jonesandjay123/3D-print-layerdock/projects/open-frame/docs/reference/concept-1.jpg

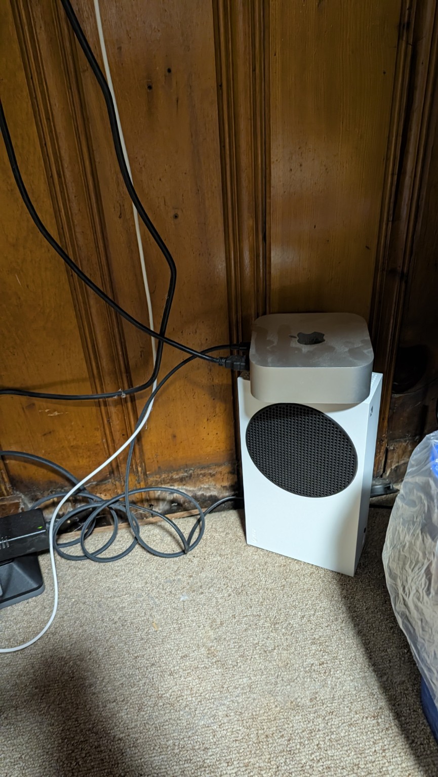
projects/open-frame/docs/reference/concept-1.jpg
