jonesandjay123/3D-print-layerdock/projects/open-frame/docs/reference/concept-4.jpg

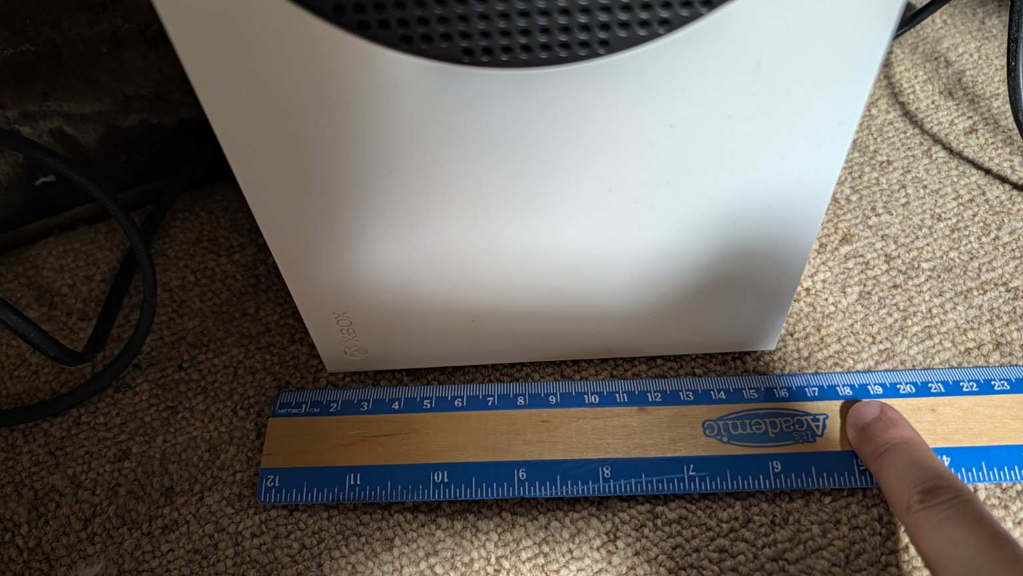
projects/open-frame/docs/reference/concept-4.jpg
