jonesandjay123/3D-print-layerdock/projects/stackable-bins/docs/concepts/concept-A.png

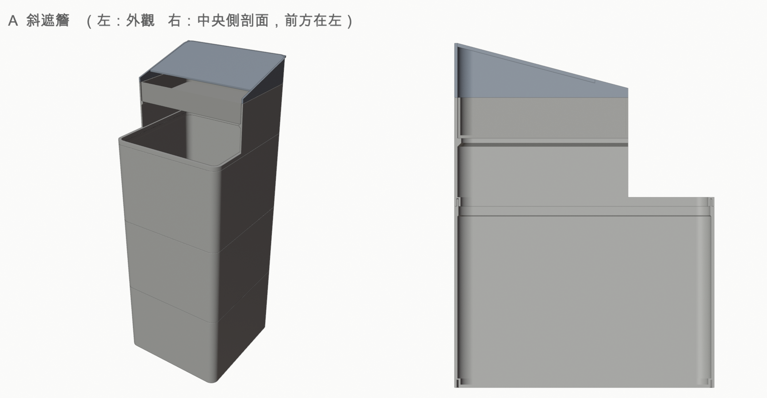
projects/stackable-bins/docs/concepts/concept-A.png
