jonesandjay123/3D-print-layerdock/projects/stackable-bins/docs/concepts/concept-B.png

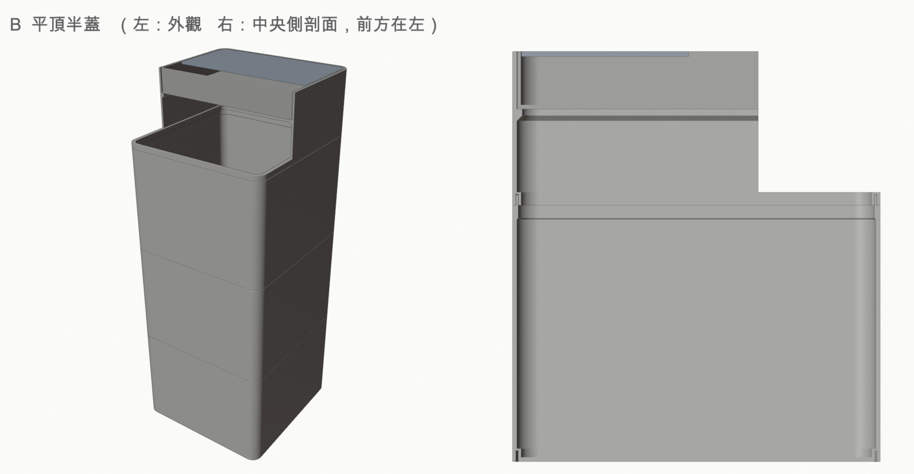
projects/stackable-bins/docs/concepts/concept-B.png
