jonesandjay123/3D-print-layerdock/projects/stackable-bins/docs/concepts/concept-C.png

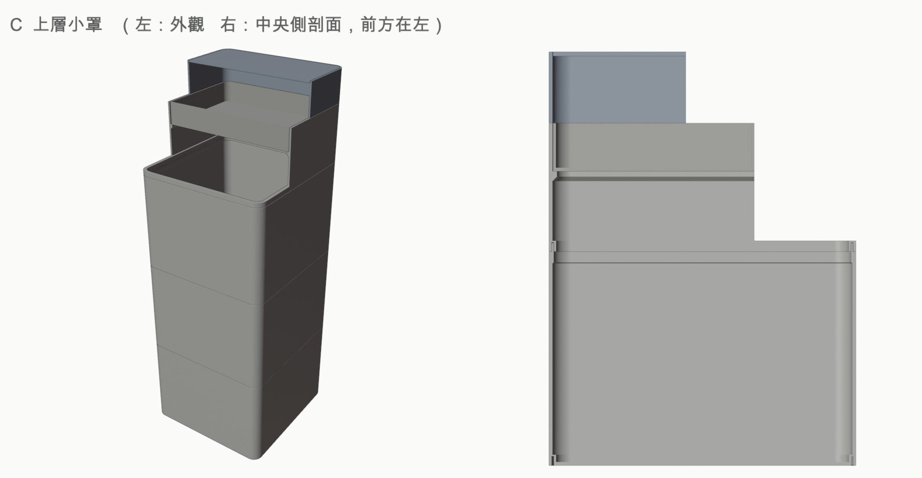
projects/stackable-bins/docs/concepts/concept-C.png
