jonesandjay123/3D-print-layerdock/projects/open-frame/print/top.3mf

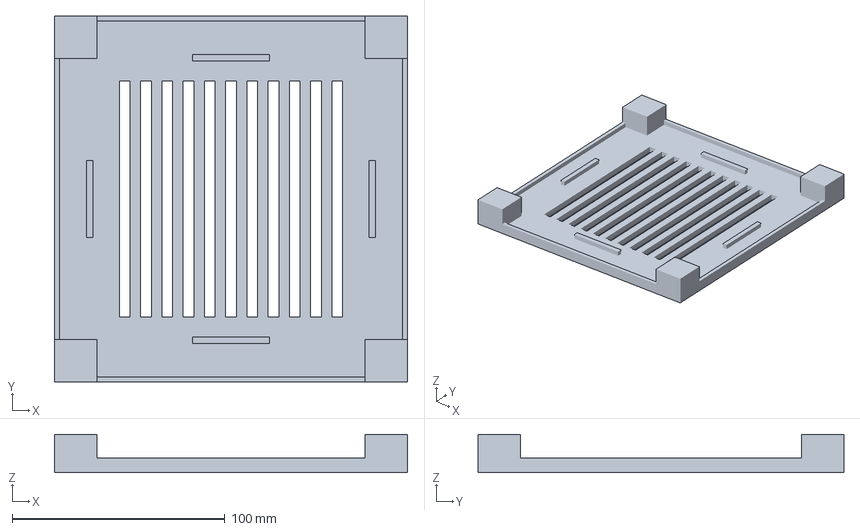
[picture p20: CAD file, 2026-10-20]
projects/open-frame/print/top.3mf
166.0 x 172.0 x 18.0 mm
