jonesandjay123/3D-print-layerdock/projects/stackable-bins/print/top.3mf

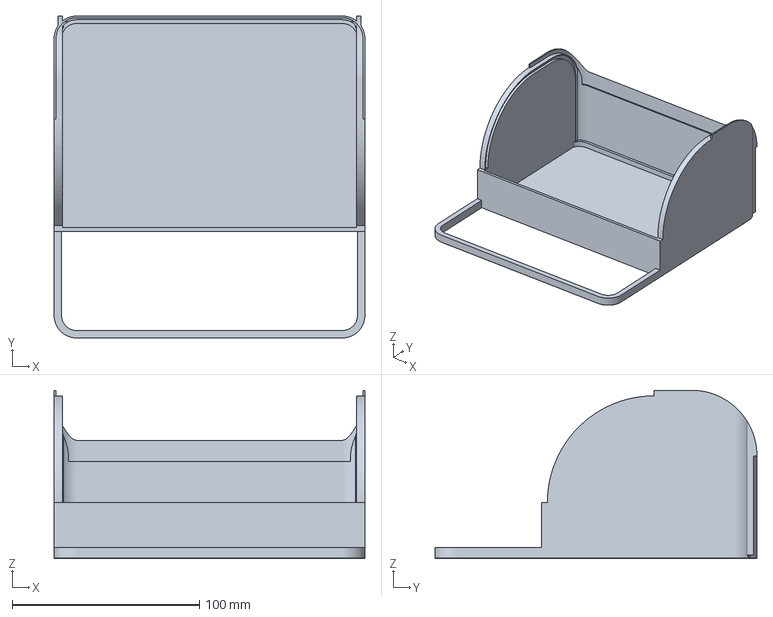
[picture p21: CAD file, 2026-10-22]
projects/stackable-bins/print/top.3mf
166.0 x 172.0 x 90.0 mm
