jonesandjay123/3D-print-layerdock/projects/open-frame/print/layer.3mf

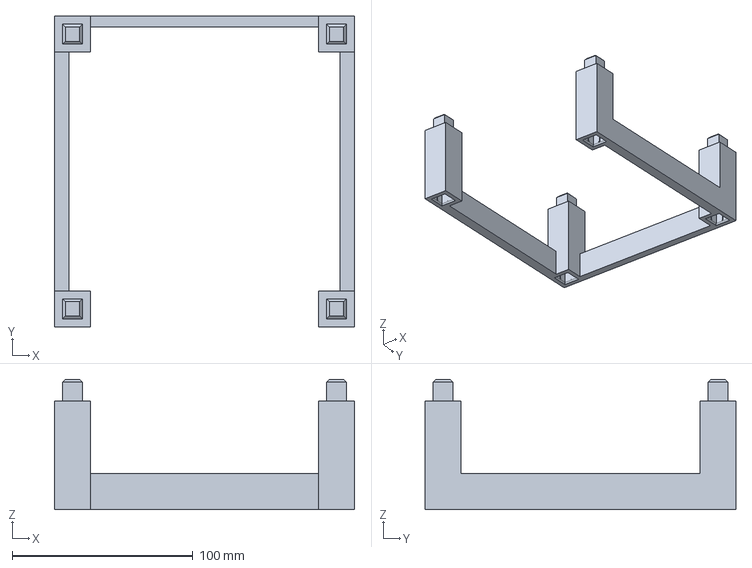
[picture p22: CAD file, 2026-10-20]
projects/open-frame/print/layer.3mf
166.0 x 172.0 x 72.0 mm
