jonesandjay123/3D-print-layerdock/projects/stackable-bins/print/roof.3mf

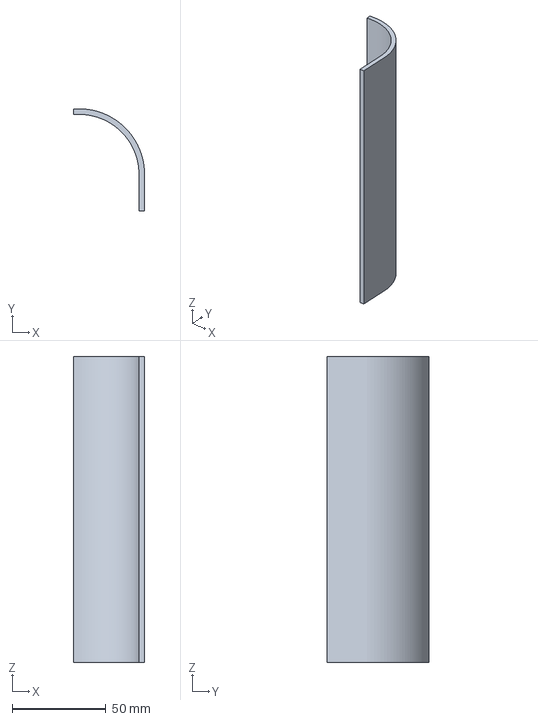
[picture p23: CAD file, 2026-10-22]
projects/stackable-bins/print/roof.3mf
38.0 x 54.7 x 163.4 mm
