jonesandjay123/3D-print-layerdock/projects/open-frame/print/test-coupon.3mf

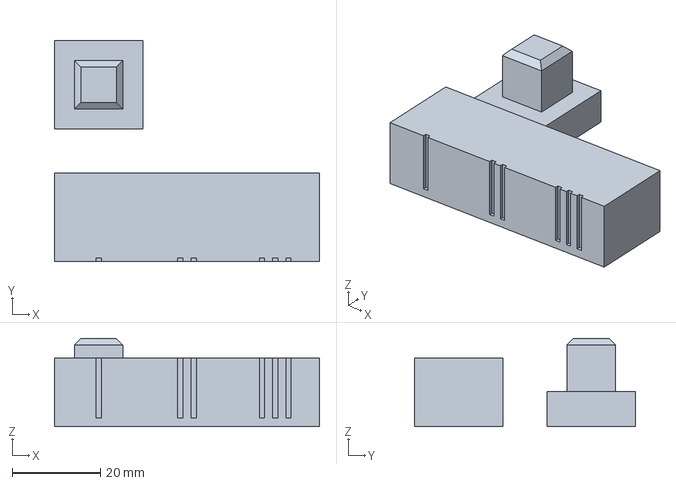
[picture p24: CAD file, 2026-10-20]
projects/open-frame/print/test-coupon.3mf
60.0 x 50.0 x 20.0 mm
