jonesandjay123/3D-print-layerdock/projects/stackable-bins/print/door.3mf

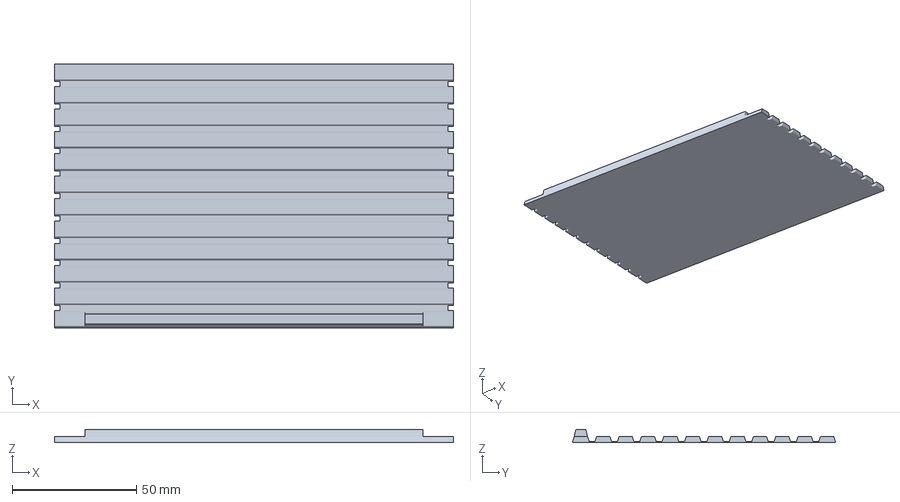
[picture p25: CAD file, 2026-10-22]
projects/stackable-bins/print/door.3mf
160.4 x 106.0 x 5.40 mm
