jonesandjay123/3D-print-layerdock/projects/open-frame/print/base.3mf

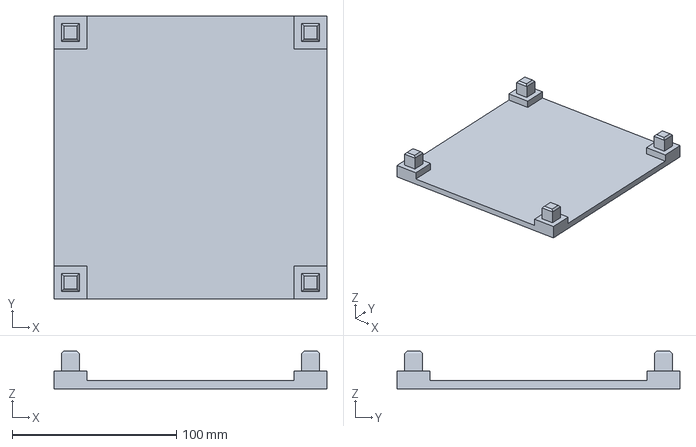
[picture p26: CAD file, 2026-10-20]
projects/open-frame/print/base.3mf
166.0 x 172.0 x 23.0 mm
