jonesandjay123/3D-print-layerdock/projects/stackable-bins/print/test-coupon.3mf

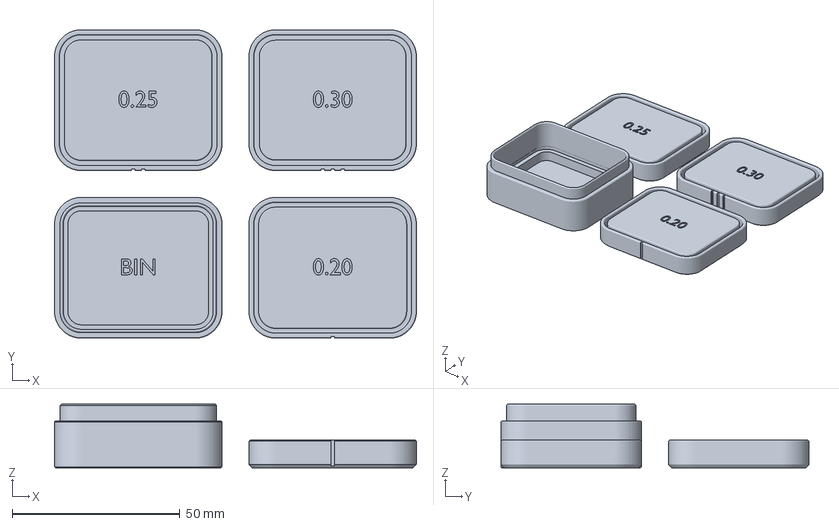
[picture p27: CAD file, 2026-10-22]
projects/stackable-bins/print/test-coupon.3mf
108.0 x 92.0 x 19.0 mm
