jonesandjay123/3D-print-layerdock/projects/stackable-bins/print/bin.3mf

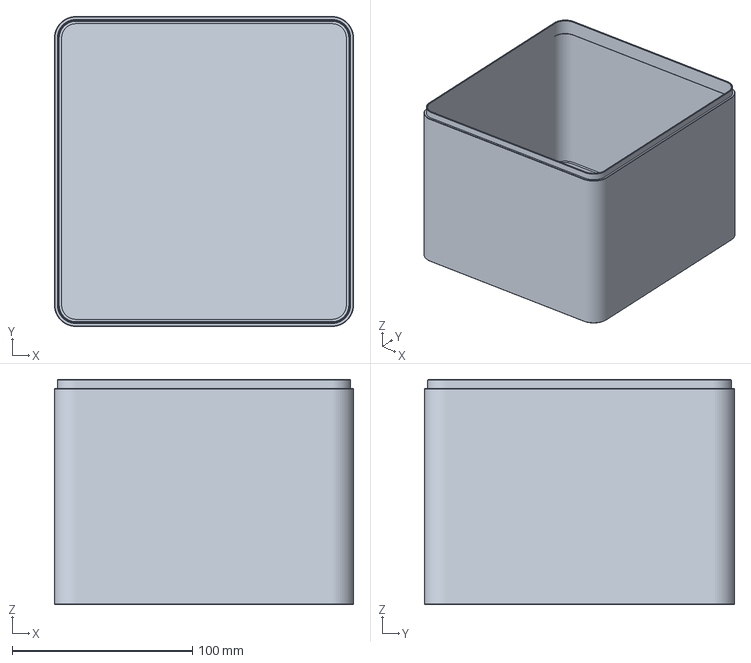
[picture p28: CAD file, 2026-10-22]
projects/stackable-bins/print/bin.3mf
166.0 x 172.0 x 125.0 mm
