jonesandjay123/3D-print-layerdock/projects/stackable-bins/print/lid.3mf

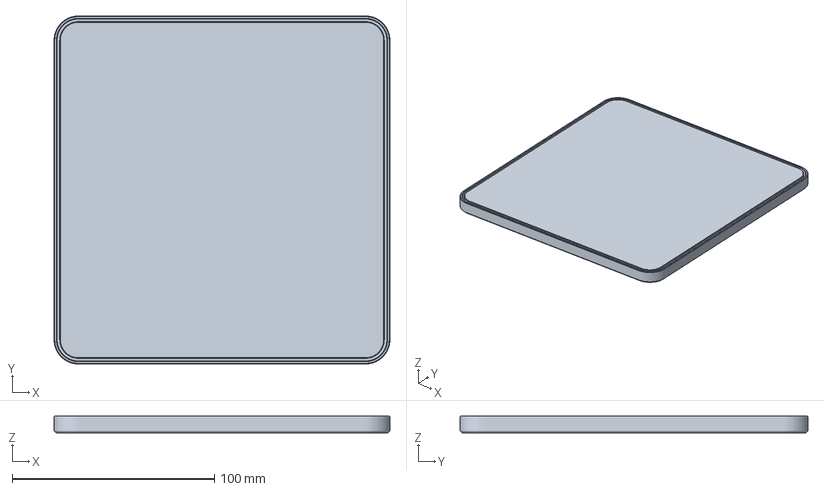
[picture p29: CAD file, 2026-10-22]
projects/stackable-bins/print/lid.3mf
166.0 x 172.0 x 8.25 mm
