jonesandjay123/3D-print-layerdock/(list of files, cad)

Other CAD files:
projects/open-frame/stl/base.stl
projects/open-frame/stl/layer.stl
projects/open-frame/stl/test-coupon.stl
projects/open-frame/stl/top.stl
projects/stackable-bins/stl/bin.stl
projects/stackable-bins/stl/door.stl
projects/stackable-bins/stl/lid.stl
projects/stackable-bins/stl/roof.stl
projects/stackable-bins/stl/test-coupon.stl
projects/stackable-bins/stl/top.stl
