jonesandjay123/3D-print-layerdock/projects/stackable-bins/docs/print-report.md

# Slicing dry run (Bambu Studio CLI)

Printer profile `Bambu Lab A1 mini 0.4 nozzle`, process `0.20mm Standard @BBL A1M`, filament `Bambu PLA Basic @BBL A1M`, plate `Textured PEI Plate`.
Process overrides: `wall_loops=3`, `elefant_foot_compensation=0.15`. Generated by `tools/slice.py`; the g-code itself is in `build/slice/` (git-ignored).

| part | print time | filament | layers | brim generated | toolpath footprint on bed (mm) | fits 180 × 180 |
| --- | --- | --- | --- | --- | --- | --- |
| bin | 4h 2m 52s | 254.95 g (84.1 m) | 624 | no (auto_brim) | 165.6 × 171.6 | yes |
| lid | 1h 48m 17s | 105.32 g (34.8 m) | 41 | no (auto_brim) | 165.6 × 171.6 | yes |
| door | 52m 36s | 34.49 g (11.4 m) | 27 | no (auto_brim) | 160.0 × 105.4 | yes |
| roof | 1h 30m 27s | 45.29 g (14.9 m) | 817 | yes (outer_only, 8 mm, set by hand) | 52.4 × 69.0 | yes |
| test-coupon | 57m 34s | 40.0 g (13.2 m) | 94 | no (auto_brim) | 107.6 × 91.6 | yes |
| top | 3h 9m 57s | 142.11 g (46.9 m) | 450 | no (auto_brim) | 165.6 × 171.6 | yes |

Profile values used: walls 3, infill 15%, supports off.
