jonesandjay123/3D-print-layerdock/projects/open-frame/docs/print-report.md

# Slicing dry run (Bambu Studio CLI)

Printer profile `Bambu Lab A1 mini 0.4 nozzle`, process `0.20mm Standard @BBL A1M`, filament `Bambu PLA Basic @BBL A1M`, plate `Textured PEI Plate`.
Stock profile values (walls, infill, brim) — nothing hand-tuned. Generated by `tools/slice.py`; the g-code itself is in `build/slice/` (git-ignored).

| part | print time | filament | layers | brim generated | toolpath footprint on bed (mm) | fits 180 × 180 |
| --- | --- | --- | --- | --- | --- | --- |
| base | 1h 40m 52s | 85.9 g (28.3 m) | 115 | no (auto_brim) | 165.6 × 171.6 | yes |
| layer | 1h 57m 5s | 69.52 g (22.9 m) | 360 | no (auto_brim) | 165.6 × 171.6 | yes |
| test-coupon | 25m 31s | 11.19 g (3.7 m) | 100 | no (auto_brim) | 59.6 × 49.6 | yes |
| top | 2h 9m 55s | 79.07 g (26.1 m) | 90 | no (auto_brim) | 165.6 × 171.6 | yes |

Profile defaults used: walls 2, infill 15%, supports off.
