jonesandjay123/3D-print-layerdock/projects/stackable-bins/docs/images/assembly-lid.png

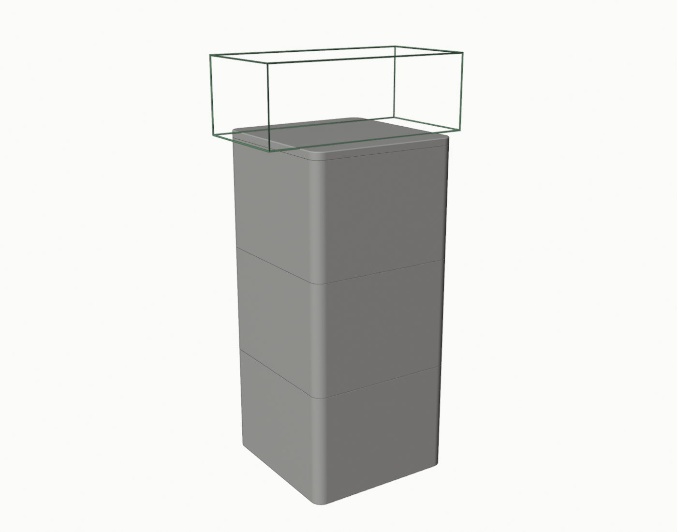
projects/stackable-bins/docs/images/assembly-lid.png
