jonesandjay123/3D-print-layerdock/(commit log)

2026-10-20 Add parametric layerdock model, STLs, Blender build script and README
    OpenSCAD source for Base / Layer / Top / Pin / test coupon with the
    Xbox Series S and Mac mini dimensions, layer height, pin clearance and
    frame size as parameters. tools/build_stl.py mirrors the geometry in
    Blender (headless) so STLs and preview renders can be produced without
    OpenSCAD. All parts fit the A1 mini bed (170 x 175 mm) as single pieces.
    [base.stl, layer.stl, layerdock.scad, pin.stl, test-coupon.stl, top.stl]
2026-10-20 v0.1.1: integrated peg-and-socket joints, A1 mini printability pass
    - Replace the 24 separate pins with square pegs on every post top and
    matching sockets (mouth chamfer + crush ribs) in the next part's bottom.
    Load still passes through the 20 x 20 mm post faces.
    - Shrink the footprint to 166 x 172 mm so a brim fits on the 180 mm bed;
    posts 20 mm; Layer rails moved to the bottom so every part prints in its
    modelled orientation with no supports.
    - Fix the v0.1 socket cutter direction bug by giving sockets one direction
    only; Top sockets now sit on the post grid (were offset 1 mm).
    - tools/build.sh fails on Blender errors instead of masking them;
    tools/check_stl.py verifies waterti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
    [base.stl, layer.stl, layerdock.scad, pin.stl, test-coupon.stl, top.stl]
2026-10-20 Slice with Bambu PLA Basic (Jones prints PLA); update README figures
2026-10-20 Test coupon: groove marks (1/2/3) on the front face identify the three socket fits
    [layerdock.scad, test-coupon.stl]
2026-10-20 socket_fit 0.25 from the first printed coupon (PLA); next coupon tests 0.20/0.25/0.30
    [layer.stl, layerdock.scad, test-coupon.stl, top.stl]
2026-10-20 Base: guide ribs and rear stop off by default (Jones wants a flat plate)
    [base.stl, layerdock.scad]
2026-10-20 Add sliced Bambu Studio project files for direct printing; stacking test passed
    [base.3mf, layer.3mf, test-coupon.3mf, top.3mf]
2026-10-20 README: record print status
2026-10-21 Restructure repo into projects/: Open Frame moves to projects/open-frame, shared tools stay in tools/
    Open Frame's build was re-run from the new location and produces byte-identical STLs;
    check_stl.py and slice.py now take --project so every product can use them.
    [base.3mf, base.stl, layer.3mf, layer.stl, layerdock.scad, test-coupon.3mf, test-coupon.stl, top.3mf]
2026-10-21 Add LayerDock Stackable Bins v0.1: hidden lip-and-groove stacking bins + lid, STLs, renders, A1 mini slice check
    [bin.3mf, bin.stl, lid.3mf, lid.stl, stackable-bins.scad, test-coupon.3mf, test-coupon.stl]
2026-10-21 Stackable Bins coupon: engrave the fit value on each mini lid and BIN on the mini bin so the parts are identifiable
    [stackable-bins.scad, test-coupon.3mf, test-coupon.stl]
2026-10-21 Stackable Bins: fit 0.20 after the PLA coupon test (0.20 tightest of 0.20/0.25/0.30); rebuilt STLs, renders and 3MFs
    [bin.3mf, bin.stl, lid.3mf, lid.stl, stackable-bins.scad, test-coupon.3mf, test-coupon.stl]
2026-10-21 Stackable Bins: fit 0.15 at Jones's request (one step tighter than the tightest coupon); rebuilt STLs, renders and 3MFs
    [bin.3mf, bin.stl, lid.3mf, lid.stl, stackable-bins.scad, test-coupon.3mf, test-coupon.stl]
2026-10-22 Stackable Bins v0.1.1: hood + tray top for the tissue use case (half-open hood with a drop-in tray), STLs, renders, 3MFs
    [bin.3mf, hood.3mf, hood.stl, lid.3mf, stackable-bins.scad, test-coupon.3mf, tray.3mf, tray.stl]
2026-10-22 Stackable Bins v0.1.2: top module per Jones's choice: hood covers 2/3, 40 mm tray, 30 mm tissue gap, curved roof plate in a rebate (printed on its side)
    [bin.3mf, hood.3mf, hood.stl, lid.3mf, roof.3mf, roof.stl, stackable-bins.scad, test-coupon.3mf]
2026-10-22 Stackable Bins v0.1.3: one-piece dome cap (high at the front, descending to the back) in the hood's rebate; side-printed with zero overhangs
    [hood.3mf, hood.stl, roof.3mf, roof.stl, stackable-bins.scad]
2026-10-22 Stackable Bins v0.2: one-piece top container (closed back 2/3 with floor, open front 1/3 down to the tissue bin) + one-piece dome cap; hood/tray removed
    [hood.3mf, hood.stl, roof.3mf, roof.stl, stackable-bins.scad, top.3mf, top.stl, tray.3mf]
2026-10-22 Stackable Bins v0.3: roll-top top container (tambour door in side tracks + fixed rear roof), STLs, renders, 3MFs
    [door.3mf, door.stl, roof.3mf, roof.stl, stackable-bins.scad, top.3mf, top.stl]
2026-10-22 README: print file list and current status (3 bins printed, roll-top top sliced, not yet printed)
